shufps/NerdNOS/3d/heatsink-19x19x15-front.step

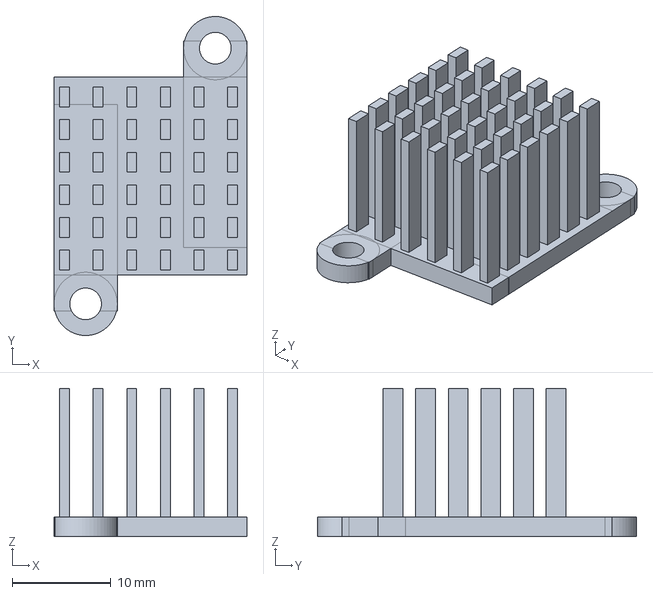
[picture p1: CAD file, 2024-09-10]
3d/heatsink-19x19x15-front.step
19.5 x 32.2 x 15.0 mm
