shufps/NerdNOS/3d/T-Display-S3.STEP

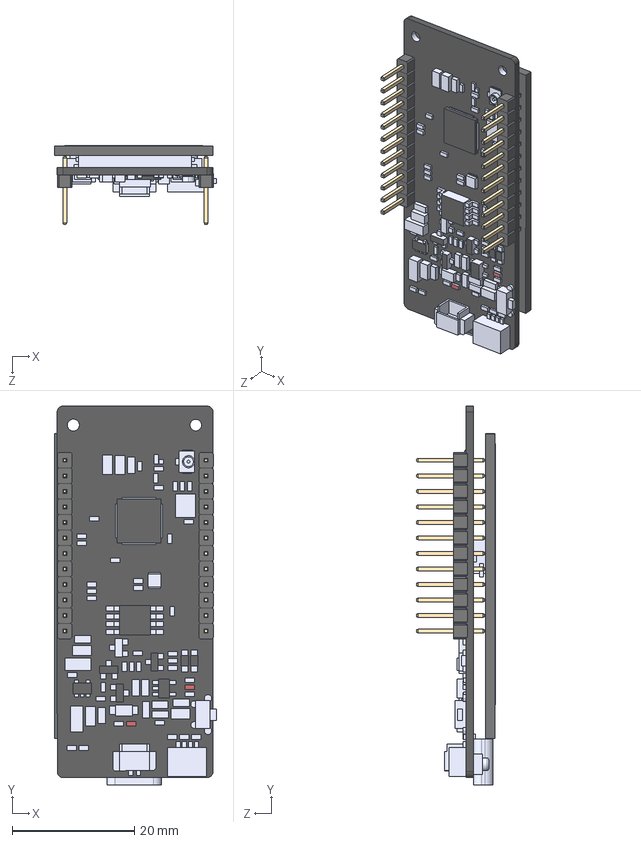
[picture p2: CAD file, 2024-08-12]
3d/T-Display-S3.STEP
26.5 x 62.0 x 12.9 mm
MainBoard_3D
Ecran
1_Male_Pin_2.54_mm x 24
