shufps/NerdNOS/(commit log)

2024-08-12 revised a little bit
    [NerdNOS.kicad_pcb, NerdNOS.kicad_sch, T-Display-S3.STEP, T_Display_S3.kicad_sch, bm1397.kicad_sch, power.kicad_sch]
2024-08-12 added current and voltage measurement
    [NerdNOS.kicad_pcb, NerdNOS.kicad_sch, T_Display_S3.kicad_sch]
2024-08-12 changed input current sensing to 1A max
    [NerdNOS.kicad_pcb, NerdNOS.kicad_sch, bm1397.kicad_sch]
2024-08-12 recalculated current sensing and gain resistor
    [NerdNOS.kicad_sch]
2024-08-12 updated ibom
    [NerdNOS.kicad_pcb]
2024-08-12 ready to go
    [NerdNOS-B_Cu.gbl, NerdNOS-B_Cu.gbr, NerdNOS-B_Mask.gbr, NerdNOS-B_Mask.gbs, NerdNOS-B_Paste.gbp, NerdNOS-B_Paste.gbr, NerdNOS-B_Silkscreen.gbo, NerdNOS-B_Silkscreen.gbr]
2024-08-28 other buck converter
    [NerdNOS.kicad_pcb, NerdNOS.kicad_sch, T_Display_S3.kicad_sch, bm1397.kicad_sch, power.kicad_sch]
2024-08-28 fixed 2 resistor order numbers
    [NerdNOS.kicad_pcb, NerdNOS.kicad_sch, power.kicad_sch]
2024-09-10 fixed reset, added "friction fit" for pinheader, new gerber
    [NerdNOS-B_Cu.gbl, NerdNOS-B_Mask.gbs, NerdNOS-B_Paste.gbp, NerdNOS-B_Silkscreen.gbo, NerdNOS-Edge_Cuts.gm1, NerdNOS-F_Cu.gtl, NerdNOS-F_Mask.gts, NerdNOS-F_Paste.gtp]
2024-09-16 added schottky diode again to prevent powering the buck from the display
    [NerdNOS.kicad_pcb, NerdNOS.kicad_sch, T_Display_S3.kicad_sch]
2024-09-16 updated gerbers for 1.3
    [NerdNOS-B_Cu.gbl, NerdNOS-B_Mask.gbs, NerdNOS-B_Paste.gbp, NerdNOS-B_Silkscreen.gbo, NerdNOS-Edge_Cuts.gm1, NerdNOS-F_Cu.gtl, NerdNOS-F_Mask.gts, NerdNOS-F_Paste.gtp]
2024-09-21 fixed 22uF digi order number, added 2pin header for fan
    [NerdNOS-B_Cu.gbl, NerdNOS-B_Mask.gbs, NerdNOS-B_Paste.gbp, NerdNOS-B_Silkscreen.gbo, NerdNOS-Edge_Cuts.gm1, NerdNOS-F_Cu.gtl, NerdNOS-F_Mask.gts, NerdNOS-F_Paste.gtp]
2024-09-21 updated bom and gerbers
    [NerdNOS-B_Cu.gbl, NerdNOS-B_Mask.gbs, NerdNOS-B_Paste.gbp, NerdNOS-B_Silkscreen.gbo, NerdNOS-Edge_Cuts.gm1, NerdNOS-F_Cu.gtl, NerdNOS-F_Mask.gts, NerdNOS-F_Paste.gtp]
